NicoG60/ThermoRegulator/physical/schema.brd

## EAGLE design physical/schema.brd (2020-12-17)

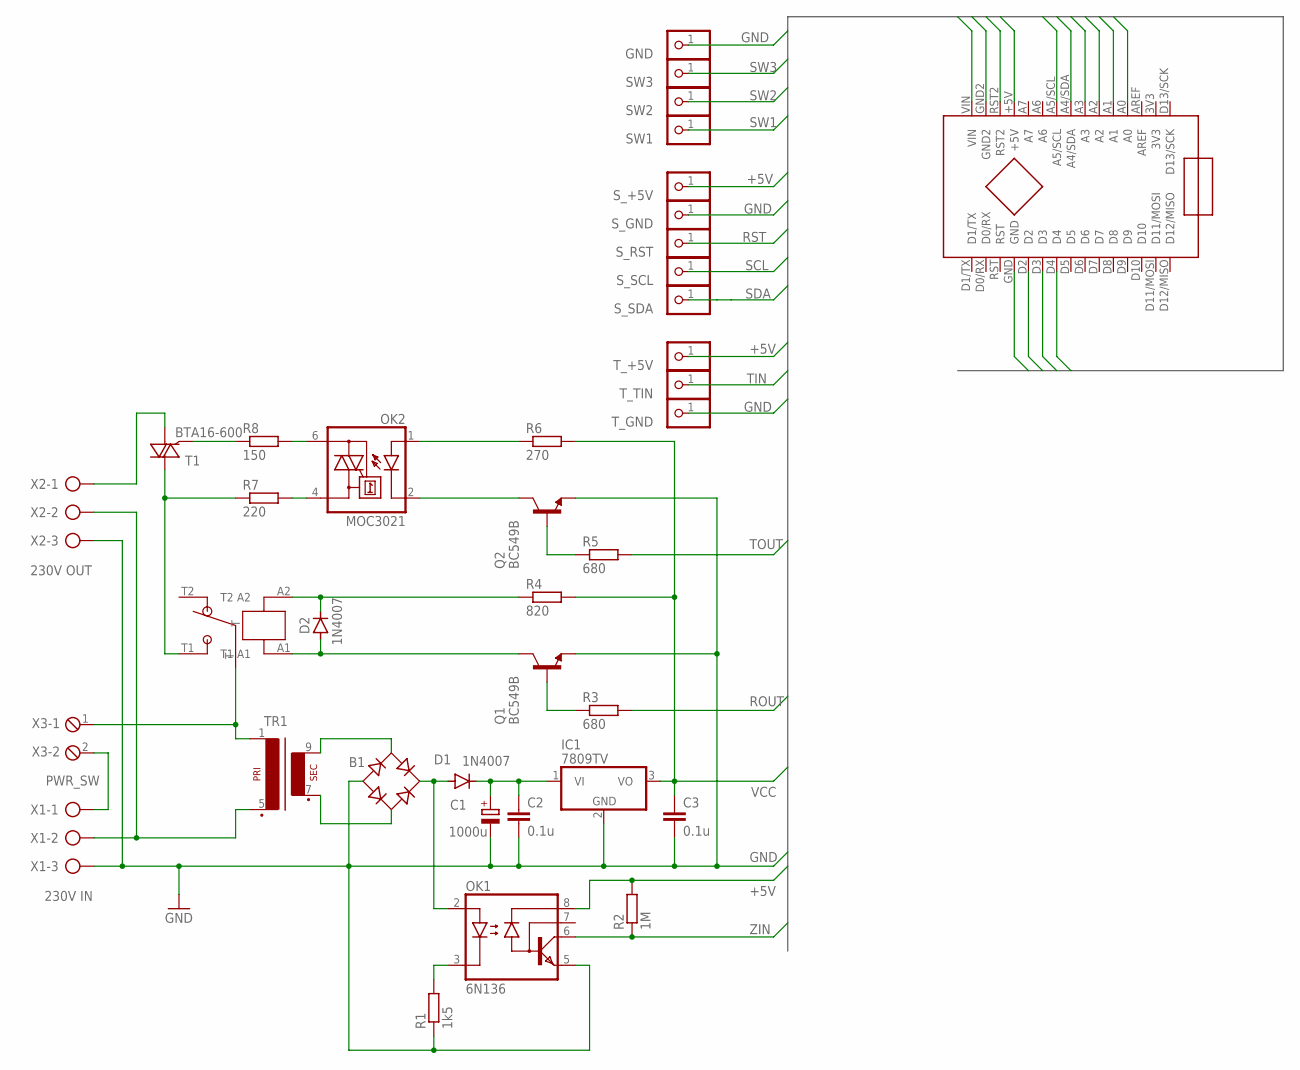
[picture p1: schematic schema.sch]

Parts:
B1: B-DIL
C1: 1000u; E5-8,5
C2, C3: 0.1u; C050-024X044
D1, D2: 1N4007; DO35-7
GND: PINHD-1X1; 1X01
IC1: 7809TV; TO220V
OK1: 6N136; DIL08
OK2: MOC3021; DIL06; MPN MOC3021
Q1, Q2: BC549B; TO92-EBC
R1: 1k5; 0204V
R2: 1M; 0204/5
R3, R5: 680; 0204/7
R4: 820; 0204/7
R6: 270; 0204/7
R7: 220; 0204/7
R8: 150; 0204/7
SW1, SW2, SW3: PINHD-1X1; 1X01
S_+5V: PINHD-1X1; 1X01
S_GND: PINHD-1X1; 1X01
S_RST: PINHD-1X1; 1X01
S_SCL: PINHD-1X1; 1X01
S_SDA: PINHD-1X1; 1X01
T1: BTA16-600; TO220BV
TR1: EI30-1
T_+5V: PINHD-1X1; 1X01
T_GND: PINHD-1X1; 1X01
T_TIN: PINHD-1X1; 1X01
U$1: FINDER_31.21.X; FINDER_32.21.X
U$2: ARDUINO_NANO
X1: 230V IN; AK500/3
X2: 230V OUT; AK500/3
X3: PWR_SW; 2POL254

Connections:
+5V: OK1.8 (VCC), R2.2, S_+5V.1, T_+5V.1, U$2.+5V
GND: B1.-, C1.-, C2.2, C3.2, GND.1, IC1.2 (GND), OK1.5 (GND), Q1.E, Q2.E, R1.1, S_GND.1, T_GND.1, U$2.GND, U$2.GND2, X1.3, X2.3
unnamed: X1.1, X3.2
unnamed: TR1.1, U$1.T, X3.1
unnamed: TR1.5 (P2), X1.2, X2.2
unnamed: OK1.3 (C), R1.2
unnamed: B1.AC1, TR1.9 (S4)
unnamed: B1.AC2, TR1.7 (S3)
unnamed: B1.+, D1.A, OK1.2 (A)
unnamed: C1.+, C2.1, D1.C, IC1.1 (VI)
unnamed: R7.1, T1.T2 (A2), U$1.T1
unnamed: T1.T1 (A1), X2.1
unnamed: D2.A, Q1.C, U$1.A1
unnamed: D2.C, R4.1, U$1.A2
unnamed: R8.1, T1.G
unnamed: OK2.6 (A2), R8.2
unnamed: OK2.4 (A1), R7.2
unnamed: Q1.B, R3.1
unnamed: Q2.B, R5.1
unnamed: OK2.2 (C), Q2.C
unnamed: OK2.1 (A), R6.1
ROUT: R3.2, U$2.A1
RST: S_RST.1, U$2.RST2
SCL: S_SCL.1, U$2.A5/SCL
SDA: S_SDA.1, U$2.A4/SDA
SW1: SW1.1, U$2.D2
SW2: SW2.1, U$2.D3
SW3: SW3.1, U$2.D4
TIN: T_TIN.1, U$2.A2
TOUT: R5.2, U$2.A0
VCC: C3.1, IC1.3 (VO), R4.2, R6.2, U$2.VIN
ZIN: OK1.6 (VO), R2.1, U$2.A3

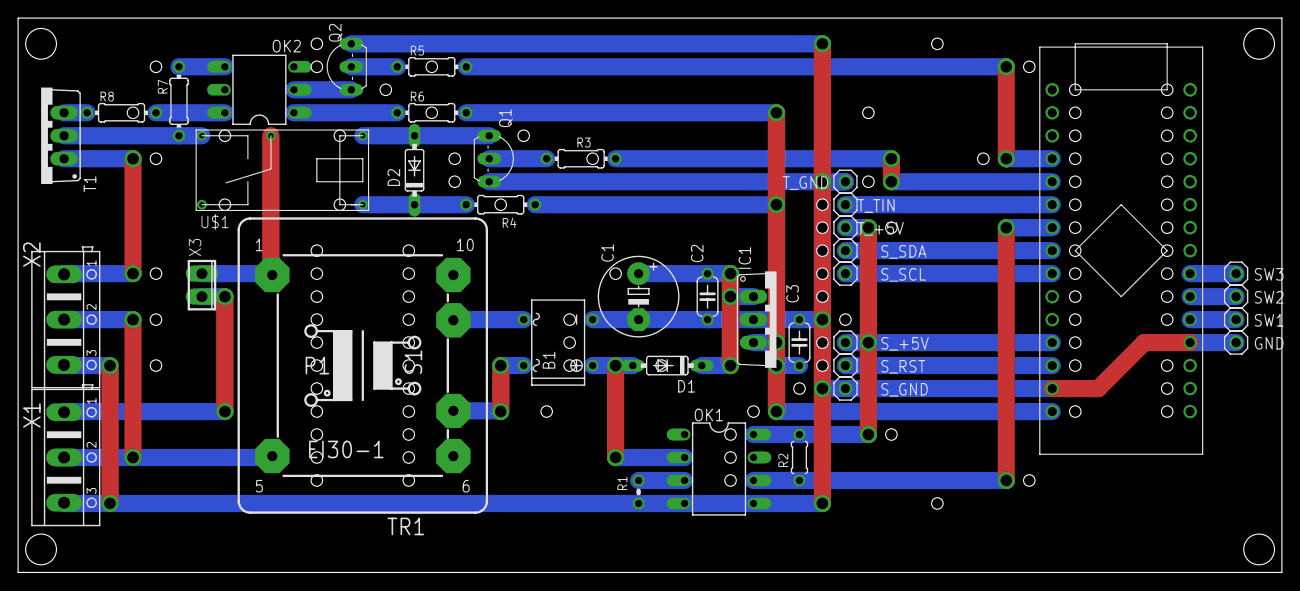
[picture p2: board schema.brd from above]

Board: 2 copper layers, 139.7 x 61.3 mm, 38 parts (0 on the bottom side), 32 nets.
