NicoG60/ThermoRegulator/include/bitmaps.h

#ifndef BITMAPS_H
#define BETMAPS_H

#define guinea_pig_w 24
#define guinea_pig_h 13

/**
 * Believe it or not, this is the bitmap of a guinea pig.
 */
const uint8_t PROGMEM guinea_pig[] = {
    0b00001111, 0b11111000, 0b00000000,
    0b00010000, 0b00011111, 0b00000000,
    0b00100000, 0b00111111, 0b11000000,
    0b01000000, 0b01111110, 0b01100000,
    0b01000000, 0b11111100, 0b00110000,
    0b10000000, 0b11111101, 0b10011000,
    0b10000000, 0b11111101, 0b00001100,
    0b10000001, 0b11111000, 0b00100110,
    0b10000001, 0b11111000, 0b00000110,
    0b01000001, 0b11111000, 0b00000110,
    0b00101101, 0b11111011, 0b00000100,
    0b00100011, 0b11111000, 0b11111000,
    0b00011100, 0b00000111, 0b00000000
};

#endif // BITMAPS_H
